andreika-git/hellen81/boards/hellen81-a/board/Produce_DanZhi.SMT_Snapshot.Top.2582135A_Y97.SMT0210410175806.png

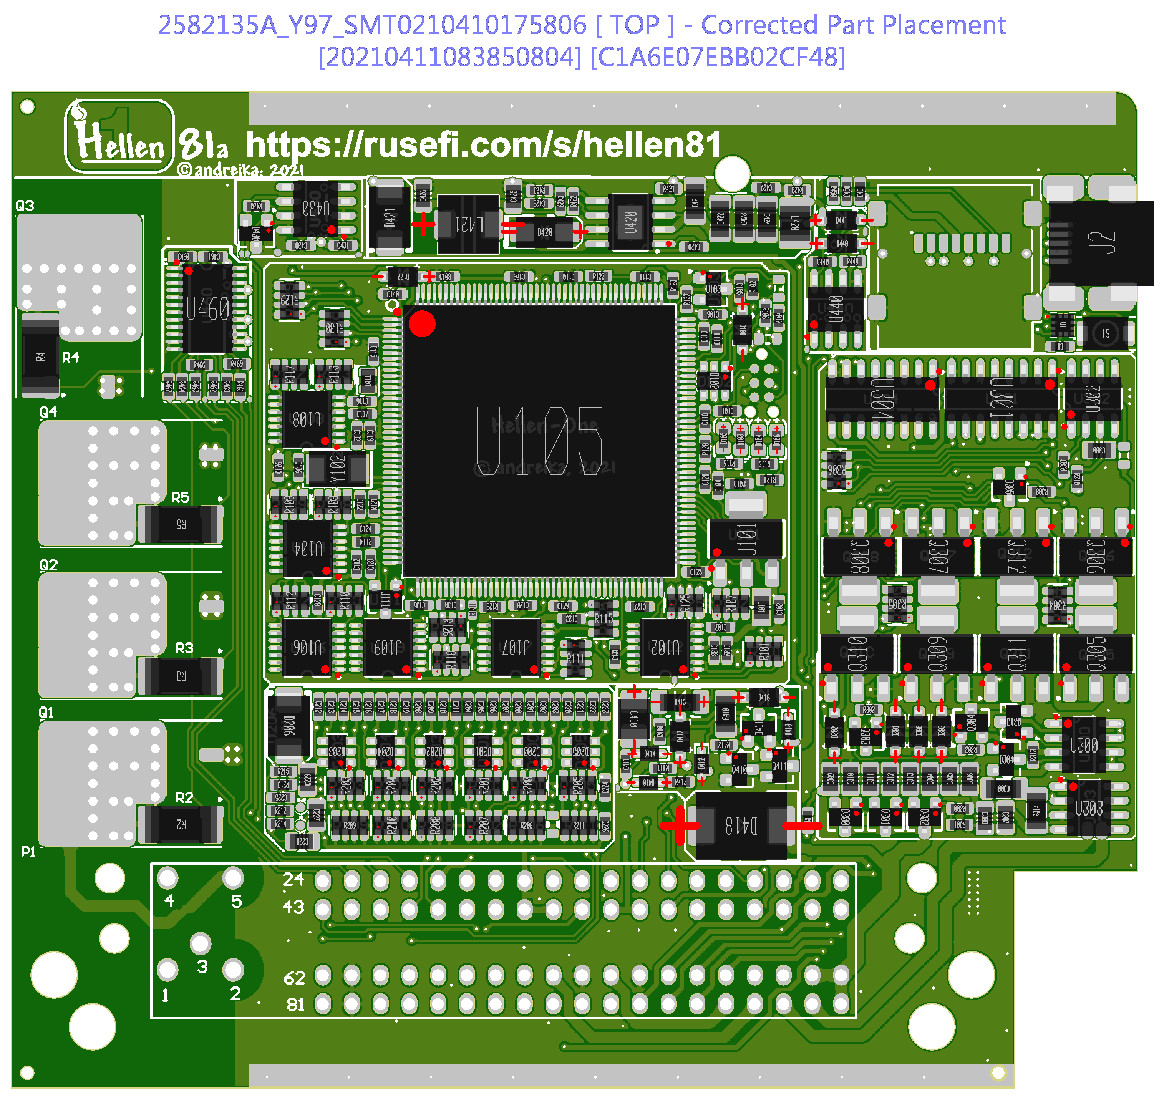
boards/hellen81-a/board/Produce_DanZhi.SMT_Snapshot.Top.2582135A_Y97.SMT0210410175806.png
