andreika-git/hellen81/boards/hellen81-a/board/misc/hellen81-a-components.png

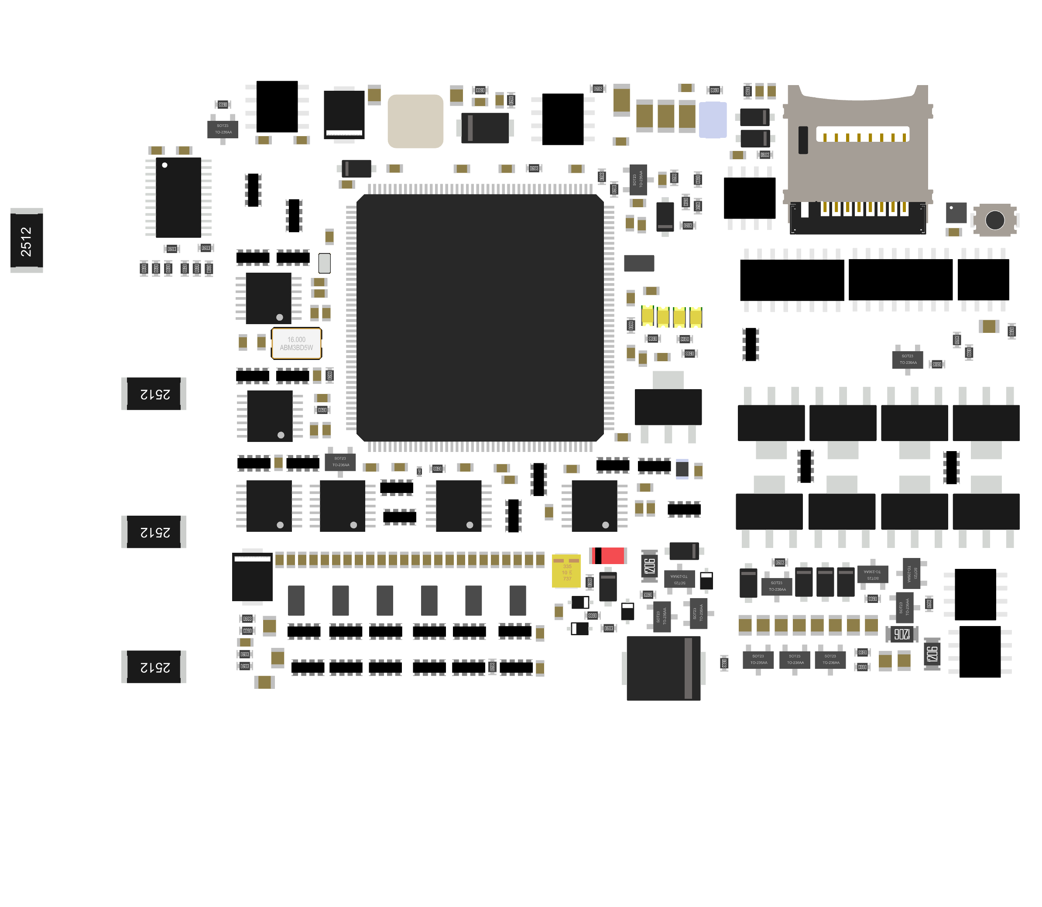
boards/hellen81-a/board/misc/hellen81-a-components.png
