andreika-git/hellen81/(threads)

Thread 2 (2022-04-16):

Do we have a problem with gerbers?

rusefillc, 2022-04-16:

Closed 2022-04-16.
