andreika-git/hellen81/boards/hellen81-a/board/hellen81-a-schematic.pdf

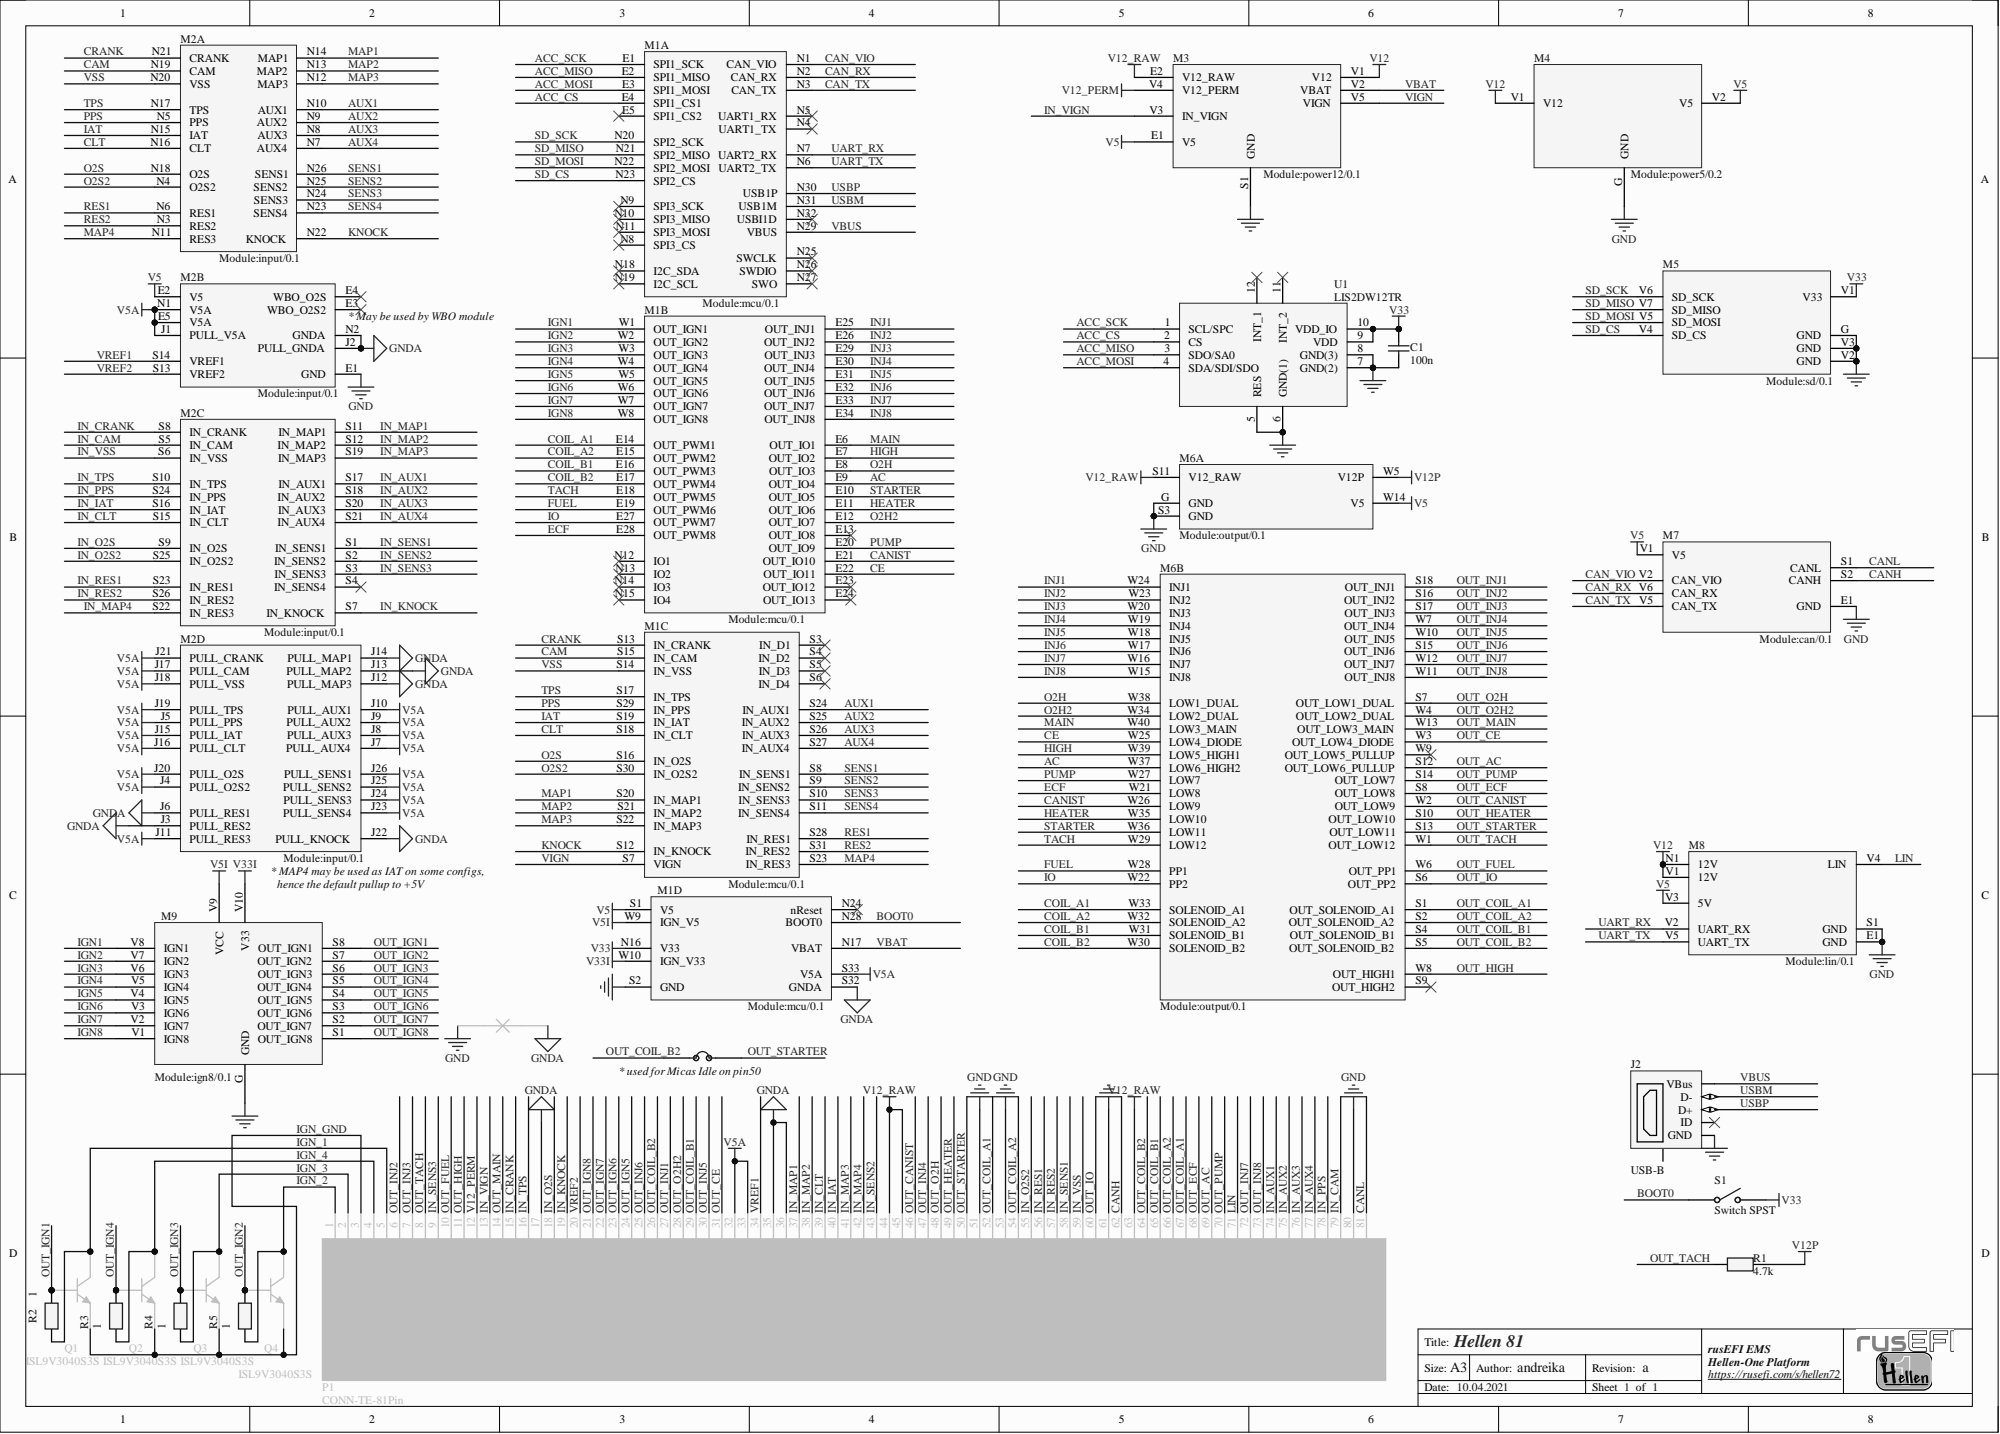
[picture p7: page 1]

* May be used by WBO module

Module:input/0.1
* MAP4 may be used as IAT on some configs,
hence the default pullup to +5V

* used for Micas Idle on pin50

IGN_4
IGN_3

IGN_2

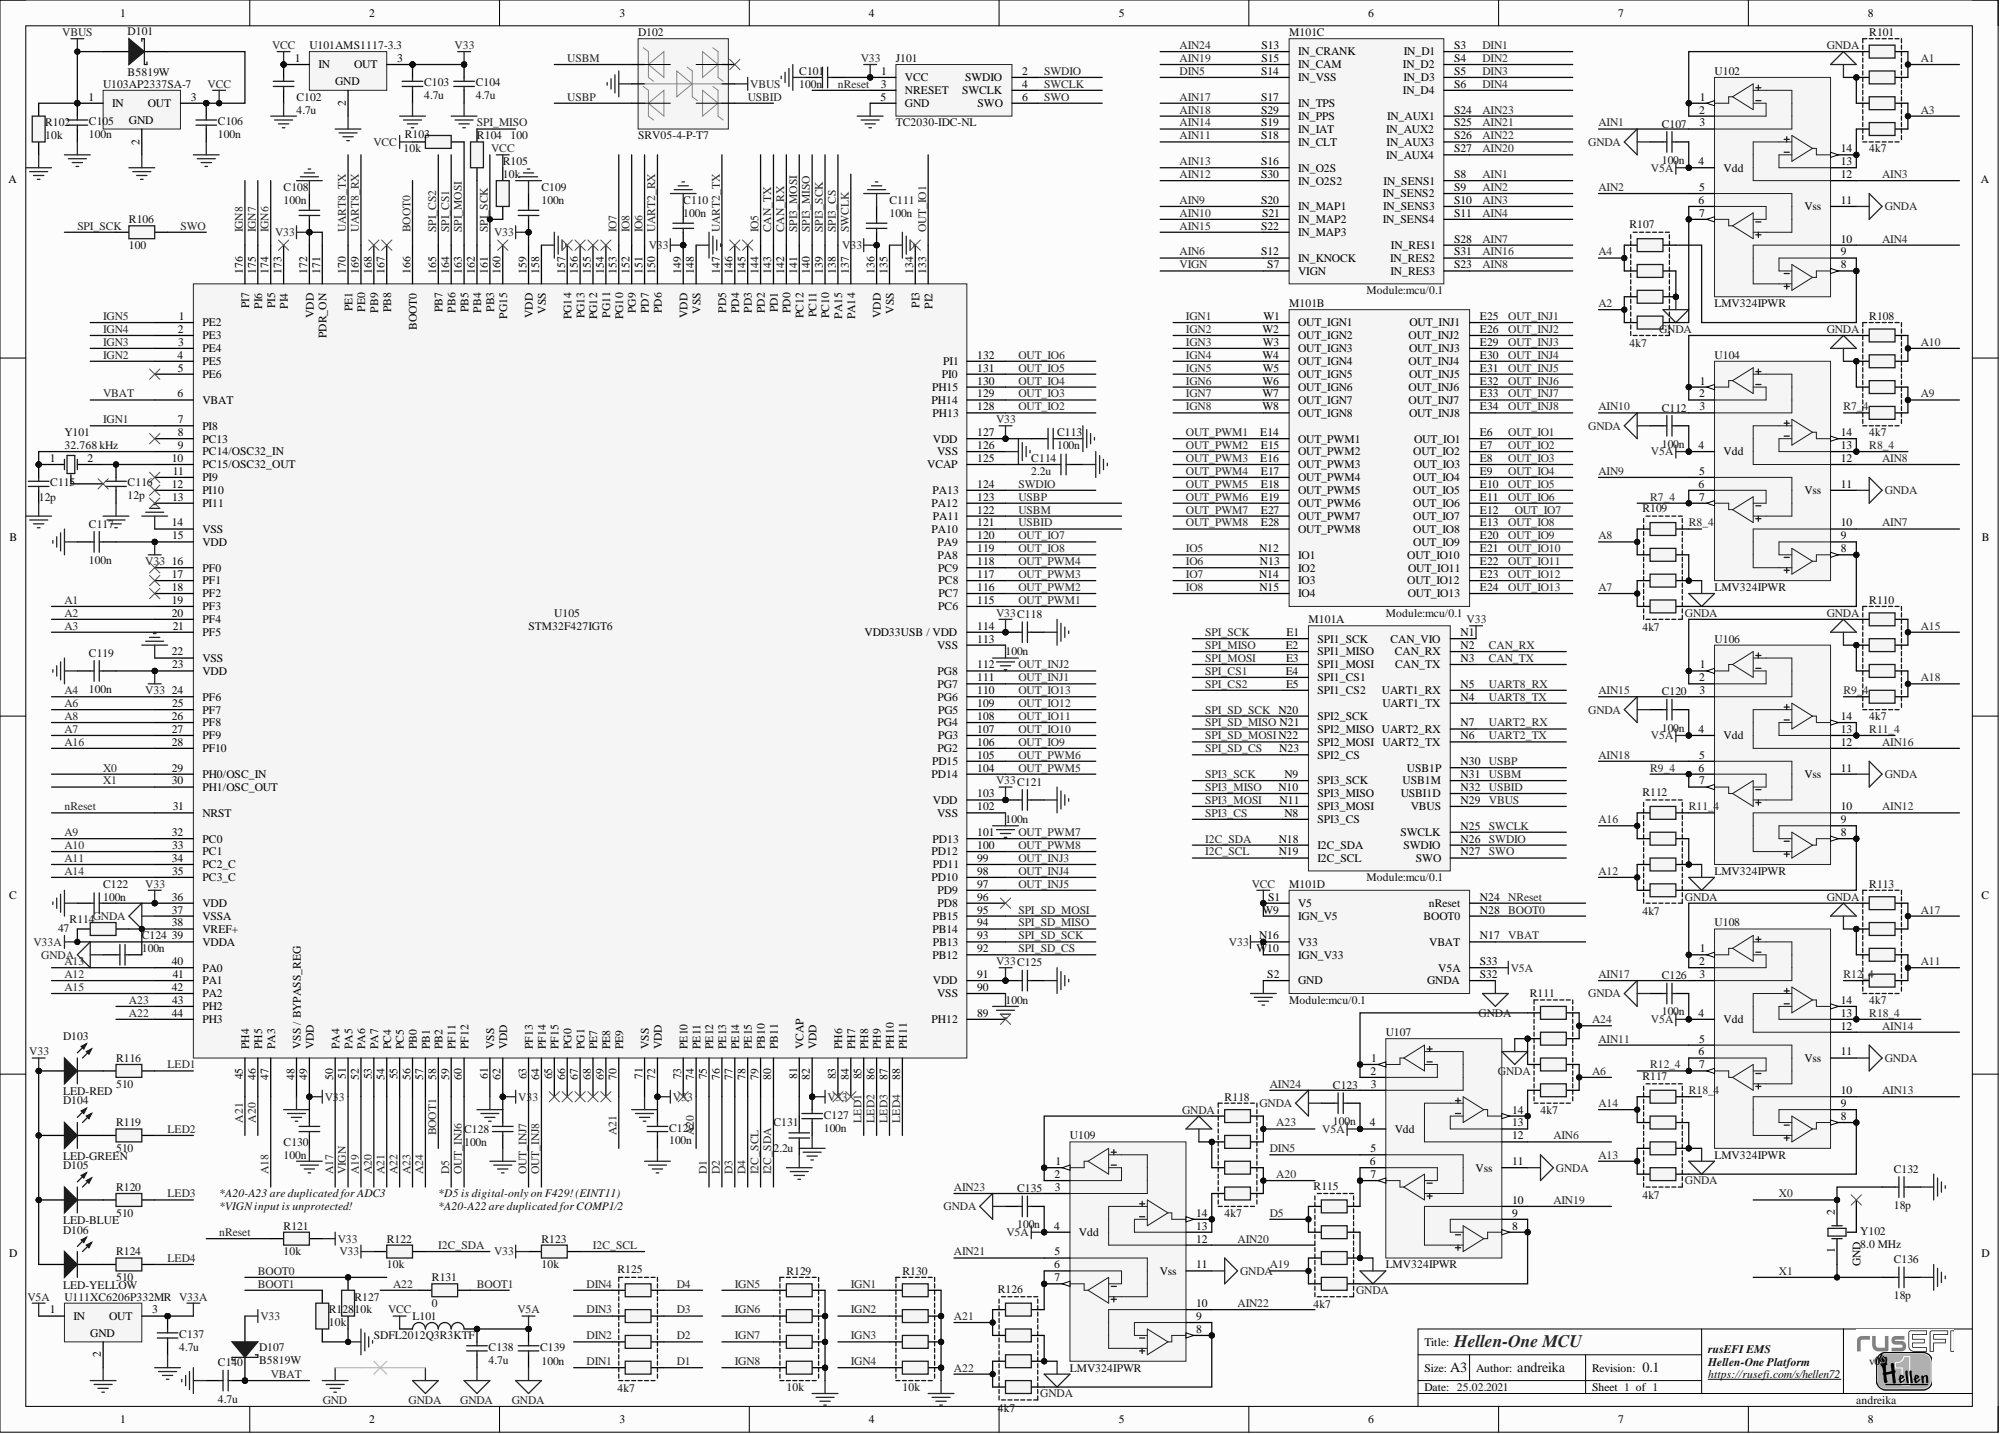
[picture p8: page 2]

D5 *D5 is digital-only on F429!(EINT11)

*A20-A23 are duplicated for ADC3
*VIGN input is unprotected!

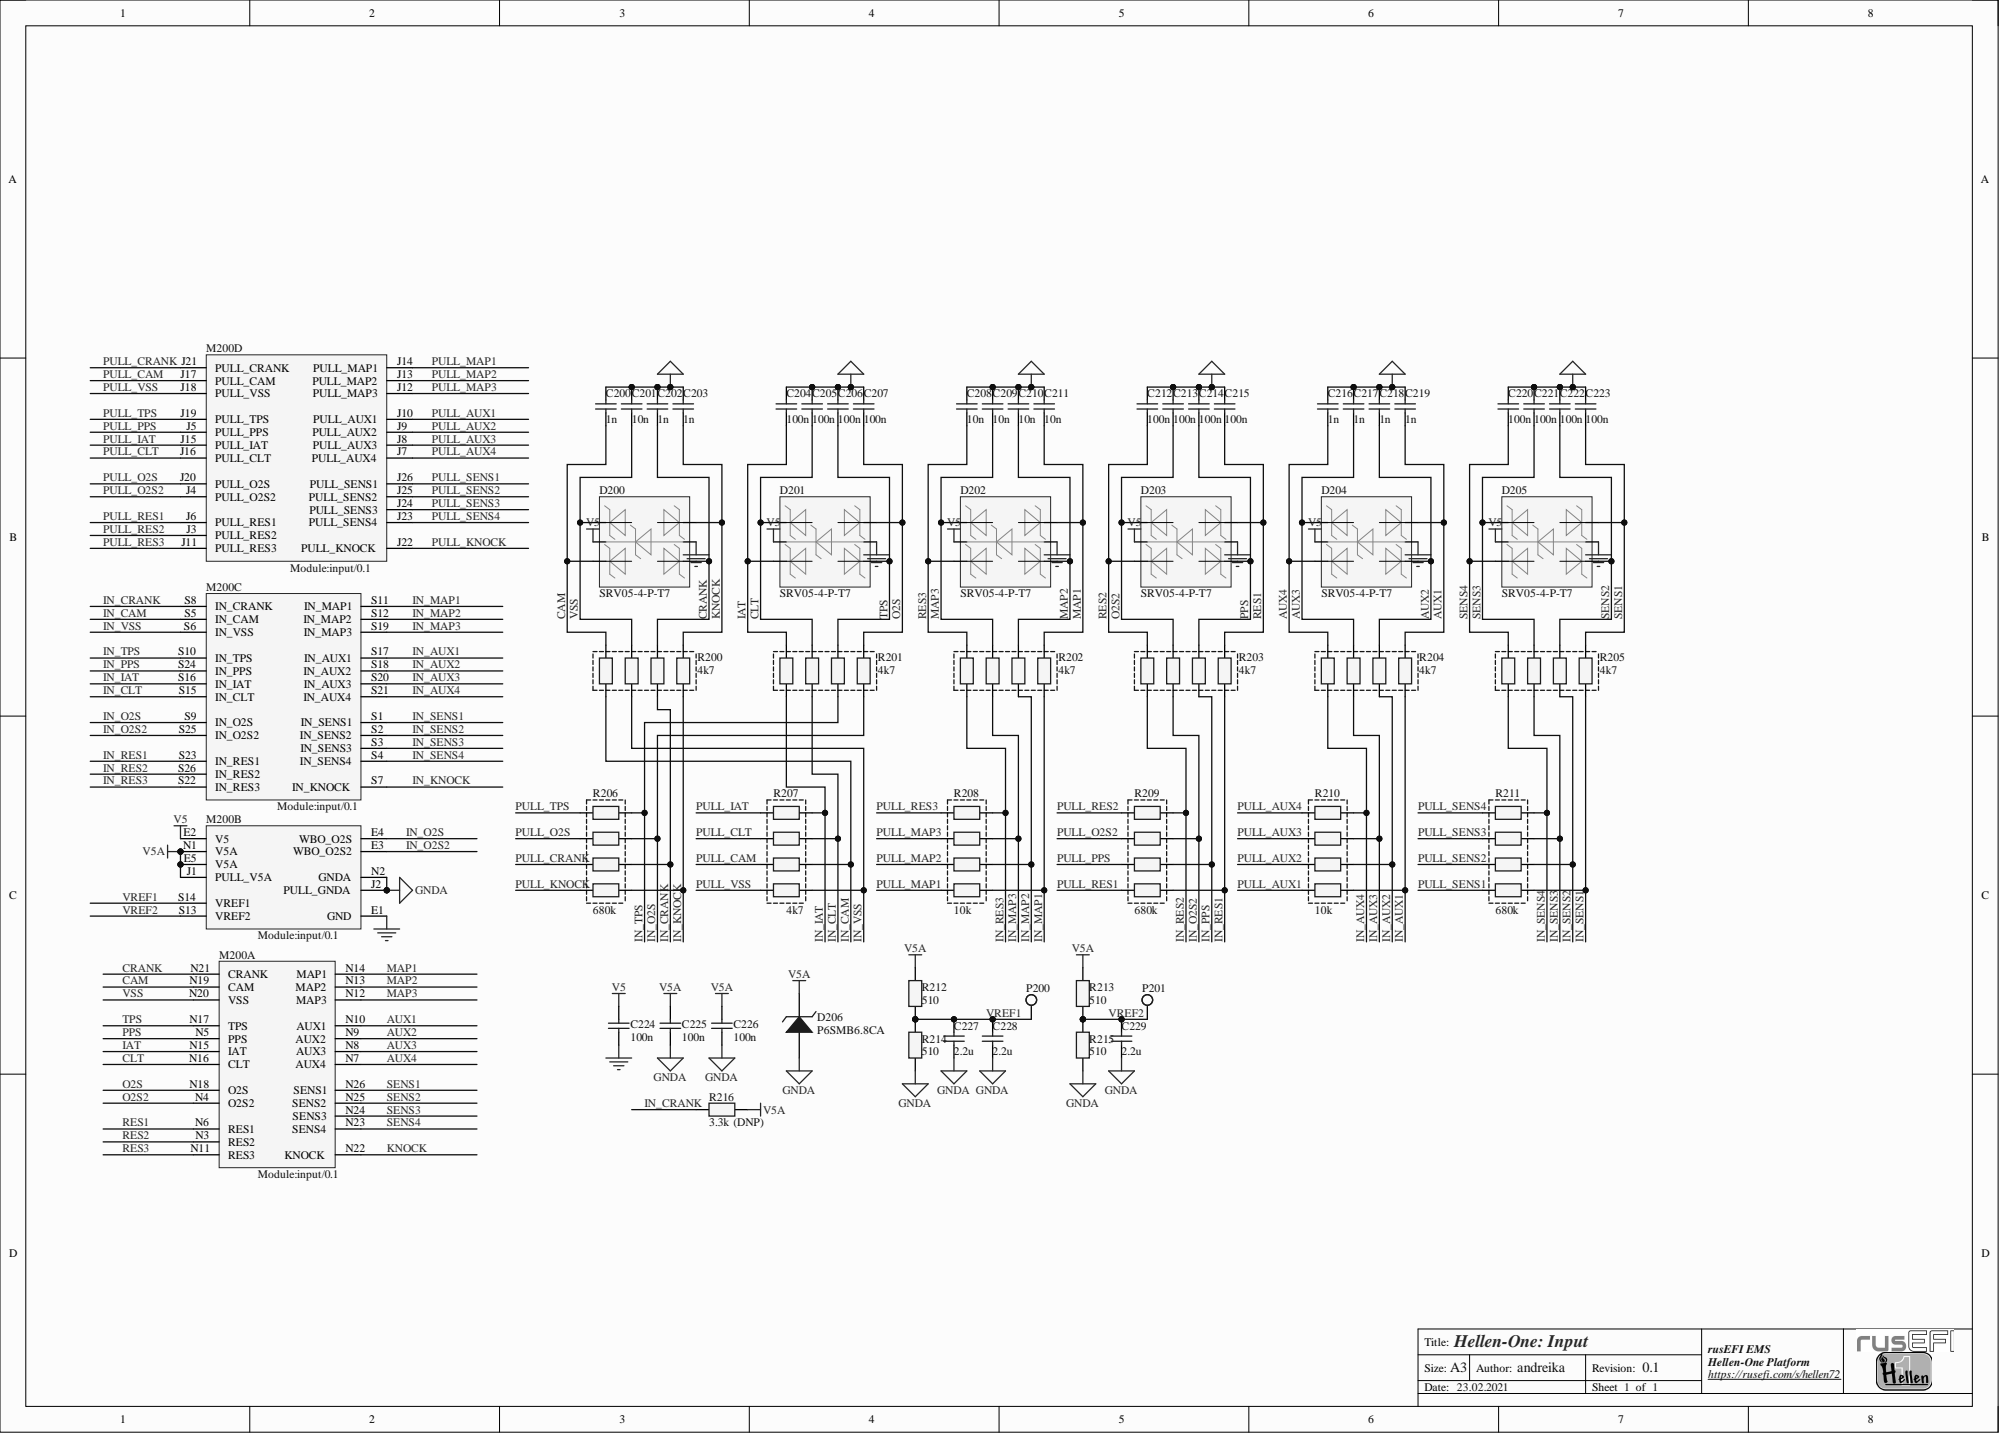
[picture p9: page 3]

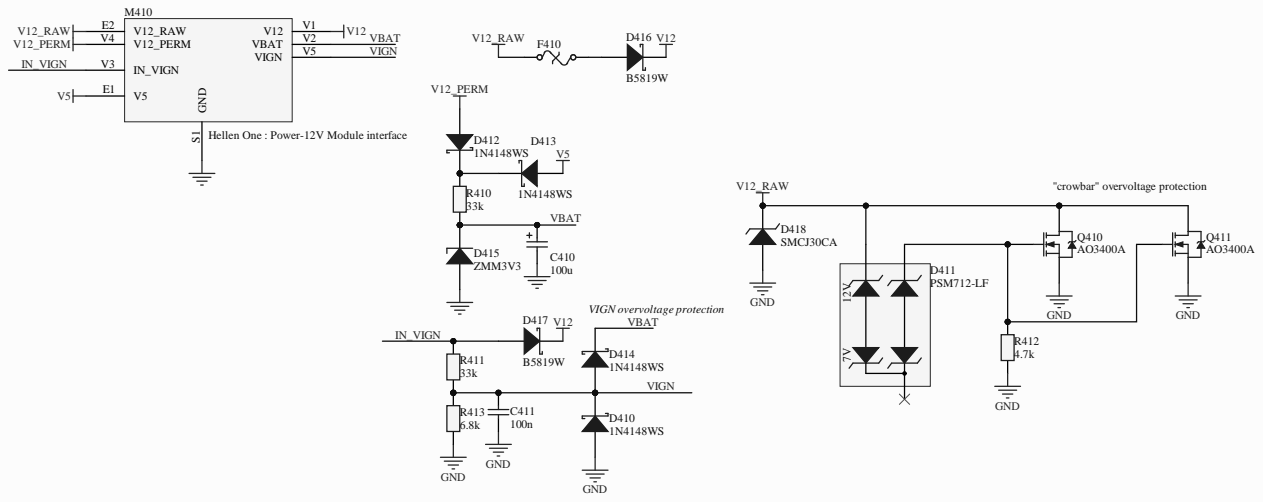
[picture p10: page 4]

Hellen One : Power-12V Module interface


2 SPI_I; 3 GND; 4 VCC; 5 SPI_SCK; 6 GND; 7 SPI_O; Molex MicroSD 47219-2001; GND; SD_CS SD_MOSI; SD_SCK; SD_MISO; V2 GND; SD_MOSI V5; SD_SCK V6 SD_MISO V7; Module:sd/0.1; SD_MOSI; SD_SCK SD_MISO

Hellen-One SD-Card

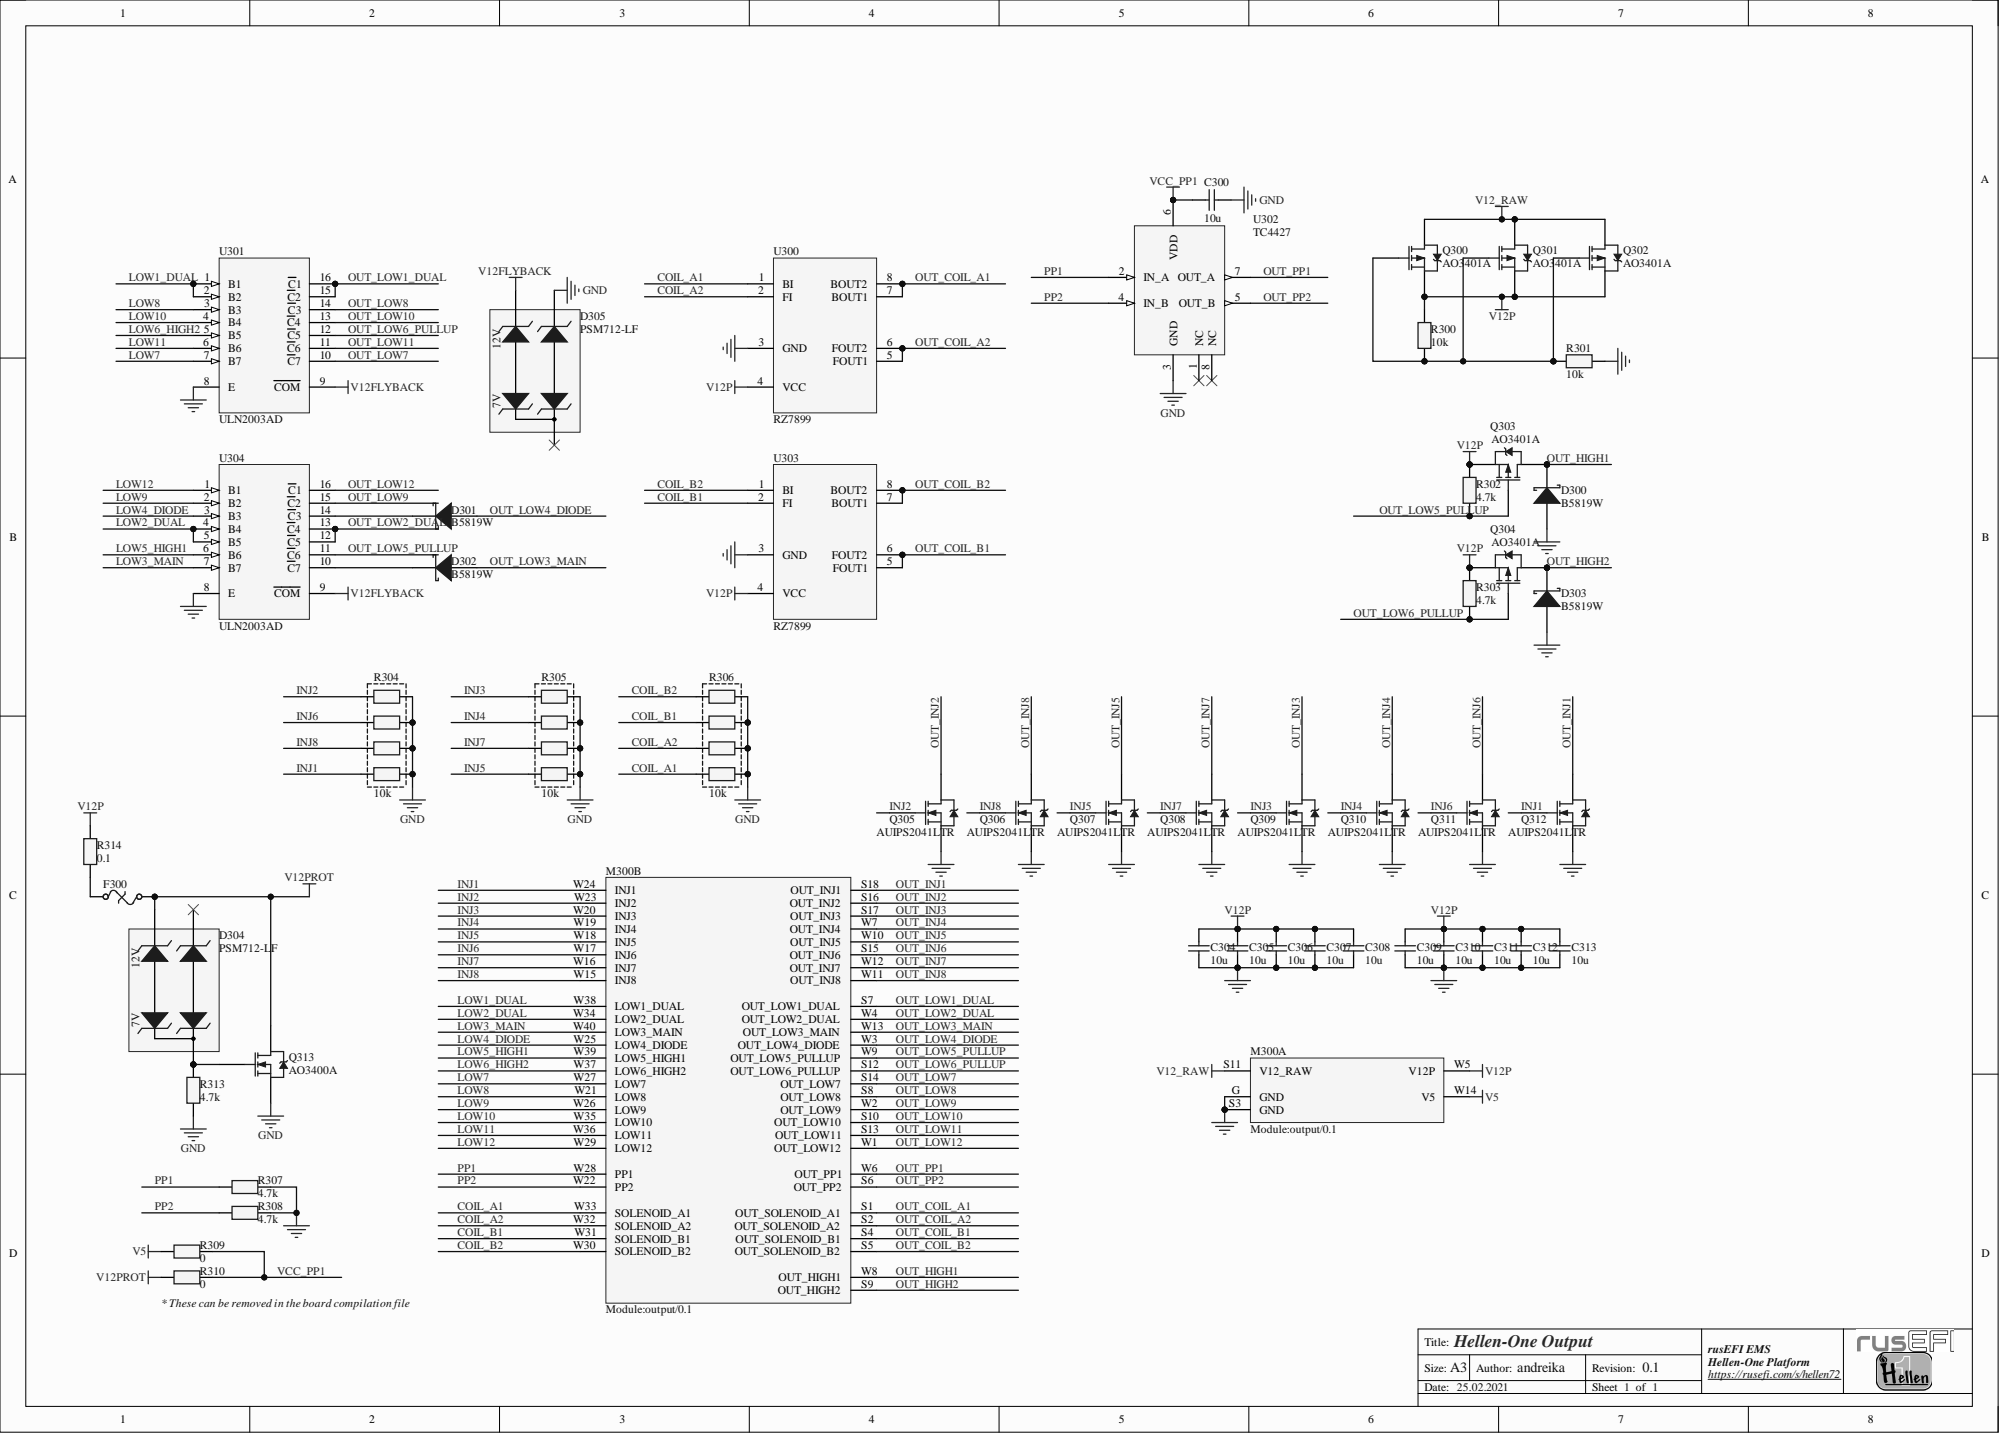
[picture p13: page 7]

* These can be removed in the board compilation file

PESD1CAN; GND; CANH; CANL; TXD 1 GND 2 VCC 3; Vio; 5 RXD 4; 6 CANH; TJA1051T/3/1J; CANH CANL; CAN_TX; CAN_RX; CAN_VIO; CAN_VIO V2; S2 CANL; CAN_TX V5; CAN_RX V6; Module:can/0.1

Hellen-One CAN

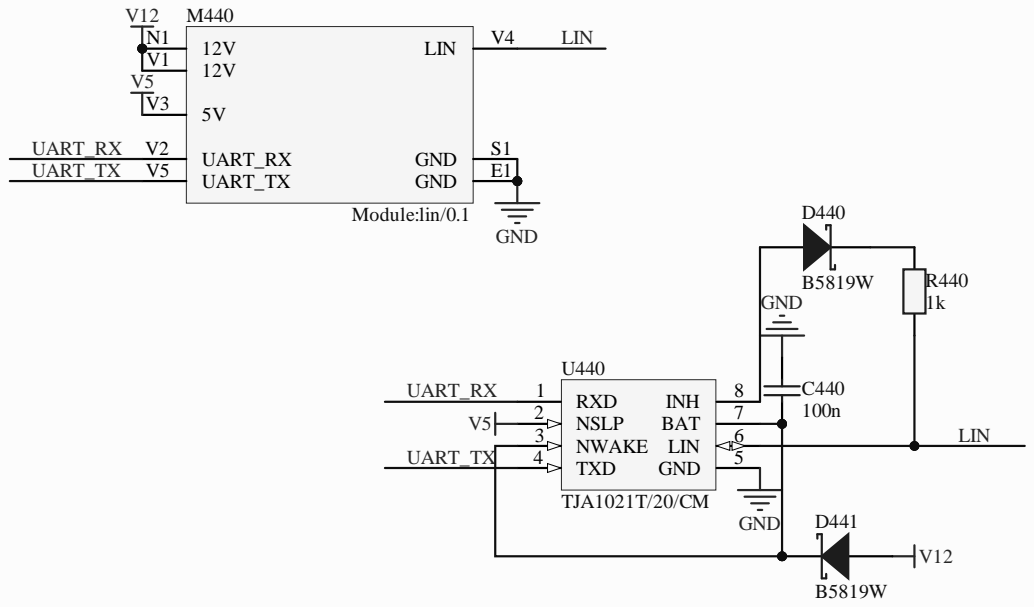
[picture p15: page 9]
RXD 1 NSLP 2 NWAKE 3; GND; 5 TXD 4; LIN; 6 BAT; 7 INH; TJA1021T/20/CM; UART_TX; UART_RX; UART_RX V2; UART_TX V5; Module:lin/0.1; UART_RX UART_TX

Hellen-One LIN

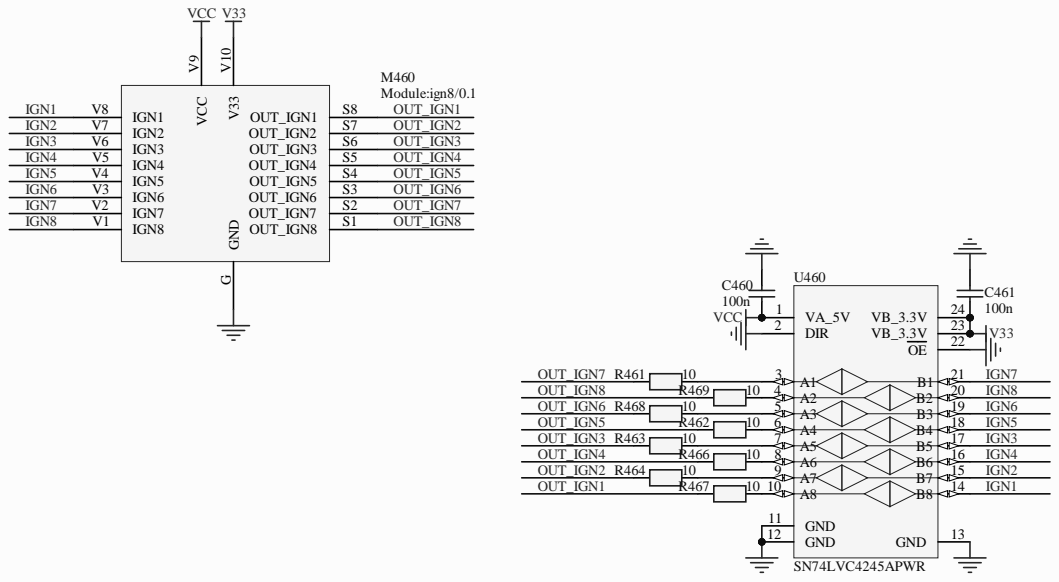
[picture p16: page 10]
