andreika-git/hellen81/boards/hellen81-a/frame/81-schematic.pdf

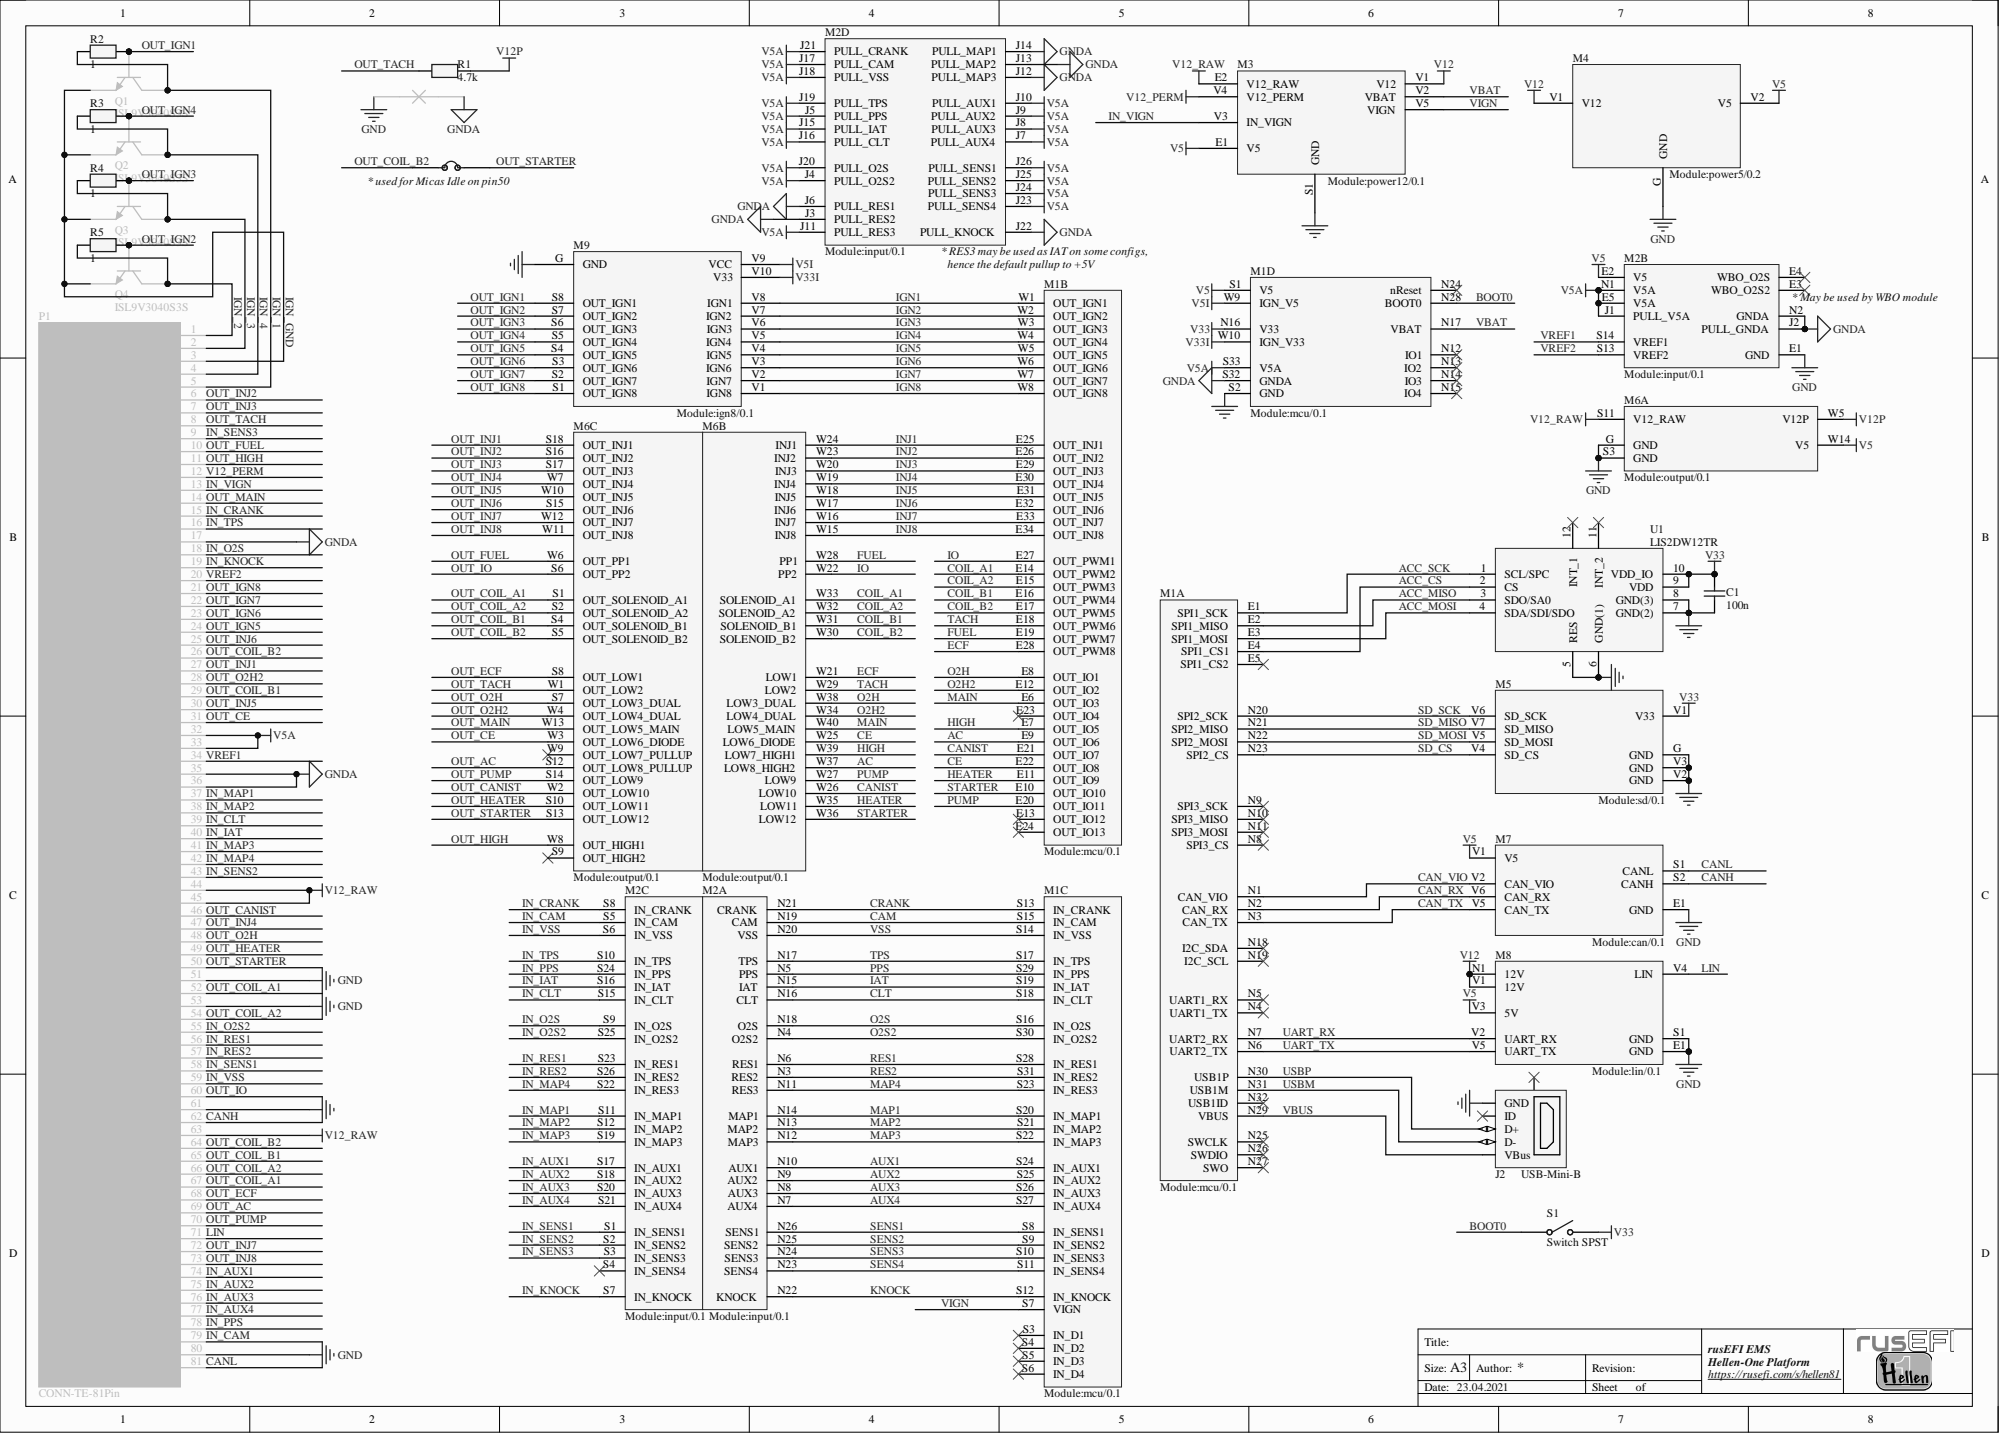
[picture p17: page 1]

rusEFI EMS https://rusefi.co
Hellen-One
