andreika-git/hellen81/boards/hellen81-a/frame/81-pcb3d.pdf

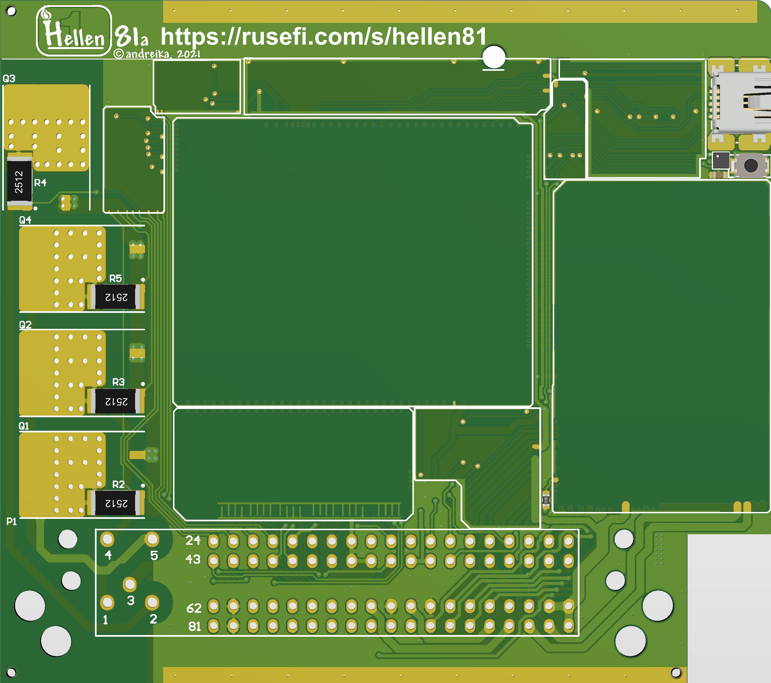
[picture p18: page 1]
