andreika-git/hellen81/(commit log)

2021-02-14 jlc usb
    [81-BOM.csv, hellen81-a-BOM.csv]
2021-03-23 Move BOM replacements to a separate csv file
    [bom_replace_81-a.csv]
2021-04-10 update frame & board files
    [81-BOM.csv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]
2021-04-10 better centroid for USB connector? (easyeda-based)
    [81-CPL.csv, 81.GBL, 81.GBO, 81.GBS, 81.GKO, 81.GTL, 81.GTO, 81.GTP]
2021-04-10 to fab!
    [hellen81-a-BOM.10april2021.csv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]
2021-04-10 Change 32kHz crystal: C99009->C97602
    [hellen81-a-BOM.10april2021.csv]
2021-04-23 refactor schematics
